blueOkiris/hudl-remot/docs/together.jpg

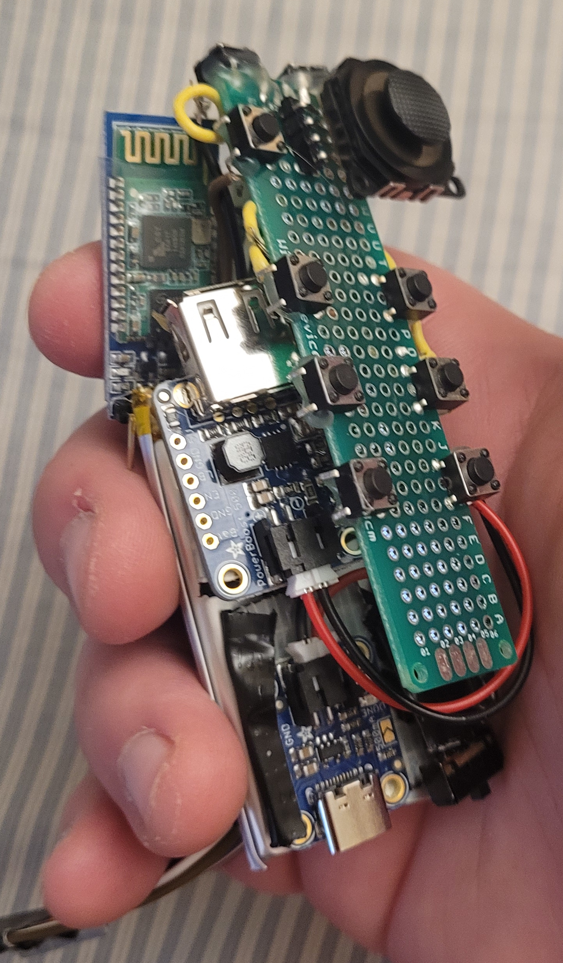
docs/together.jpg
