blueOkiris/hudl-remot/(commit log)

2021-03-22 Disabled hid code so I can focus on wireless with serial debug
2021-03-22 Switched wireless to use HC-05 in slave mode
2021-03-22 Added wireless communication for physical
2021-03-23 Added function for reading button states and sending it over bluetooth
2021-03-23 Implemented button pressed function
2021-03-23 Added basic setup for interpretation of button signal from wireless to hid
2021-03-23 Added pairing code to the wireless libraries
2021-03-24 Implemented keyboard outputs for Hudl from switch statement
2021-03-24 Added mouse button presses to hid
2021-03-24 Added const qualifier to wireless.init in physical
2021-03-27 Switched to C++. Big overhaul. Moved bluetooth implementations into single, combined library.
2021-03-27 Sucessfully got bluetooth communication as master pico!
2021-03-27 Sucessfully got buttons sending the correct message across bluetooth
    [ButtonIds.hpp, Controller.cpp, main.cpp]
2021-03-27 Physical device complete!
2021-03-28 Figured out that HID interferes with uart0, so the hid code has to use uart1 for its bluetooth
    [Wireless.cpp, Wireless.hpp, main.cpp]
2021-03-28 Bug fixes. Device complete!
    [main.cpp]
2021-03-28 Added diagram of system fitted into its case
